jaddib/PACS-21-Hardware/README.md

# PACS-21-Hardware
Here is where we will store our schematics and PCBs
:)
