jaddib/PACS-21-Hardware/Added Component Footprints/ASPI_0630LR_3R3M_T15/ASPI-0630LR-3R3M-T15.step

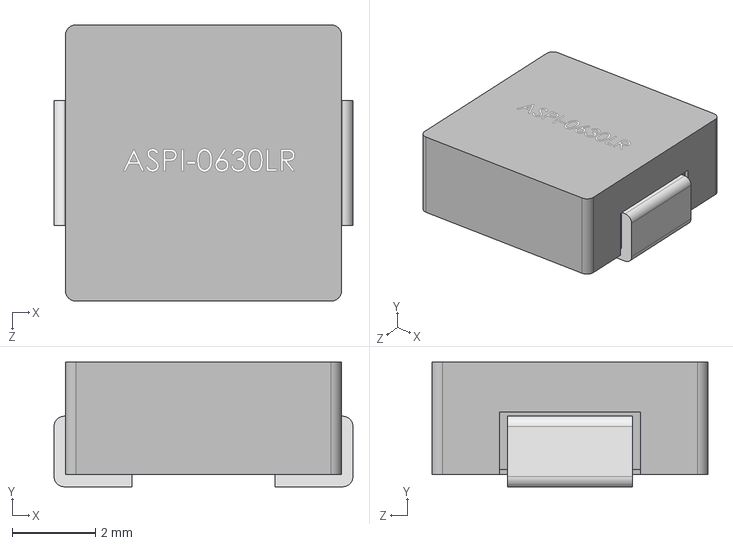
[picture p1: CAD file, 2025-01-23]
Added Component Footprints/ASPI_0630LR_3R3M_T15/ASPI-0630LR-3R3M-T15.step
7.20 x 3.00 x 6.65 mm
