jaddib/PACS-21-Hardware/Added Component Footprints/BSS84PH6327XTSA2/BSS84PH6327XTSA2.step

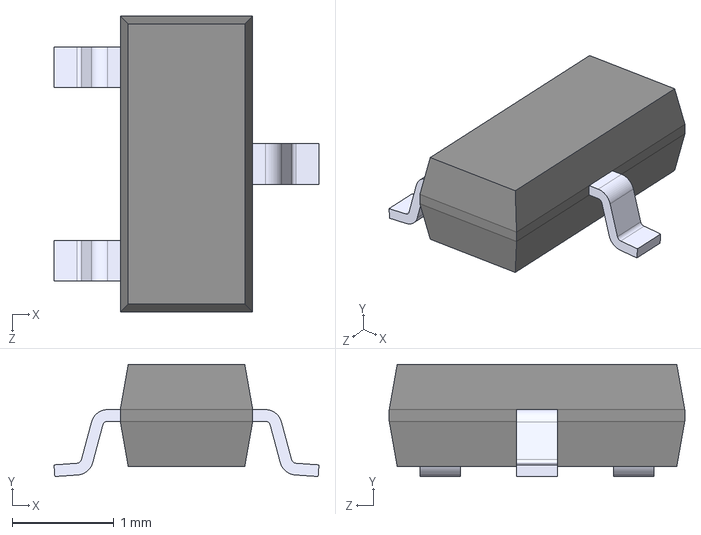
[picture p2: CAD file, 2024-12-08]
Added Component Footprints/BSS84PH6327XTSA2/BSS84PH6327XTSA2.step
2.60 x 1.10 x 2.90 mm
