jaddib/PACS-21-Hardware/Added Component Footprints/TPS562201DDCR/TPS562201DDCR.step

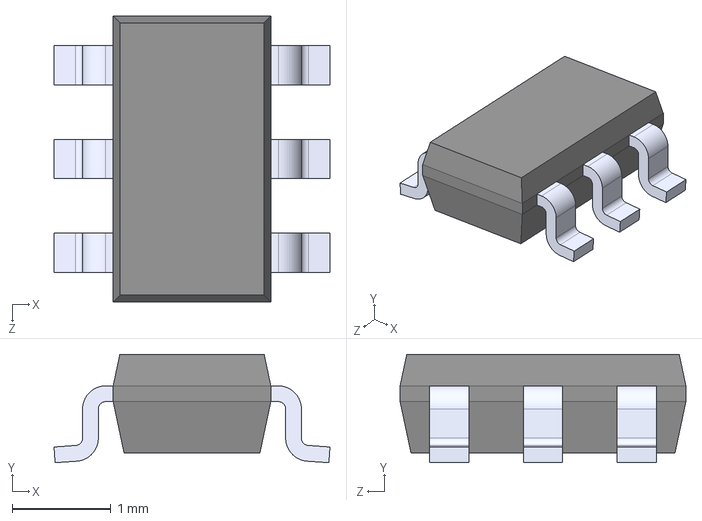
[picture p3: CAD file, 2024-11-30]
Added Component Footprints/TPS562201DDCR/TPS562201DDCR.step
2.80 x 1.10 x 2.90 mm
