jaddib/PACS-21-Hardware/(list of files, cad)

Other CAD files:
PACS Fusion Files/PACS Battery Box NEW v4.f3d
PACS Fusion Files/PACS PCB Box NEW v12.f3d
PACS Fusion Files/Plug for battery port v2.f3d
PACS Fusion Files/sprinkler for tube v1.f3d
