jaddib/PACS-21-Hardware/PACS_1.0/PACS_1.0.kicad_pcb

## KiCad design PACS_1.0/PACS_1.0.kicad_pcb (2025-02-16)

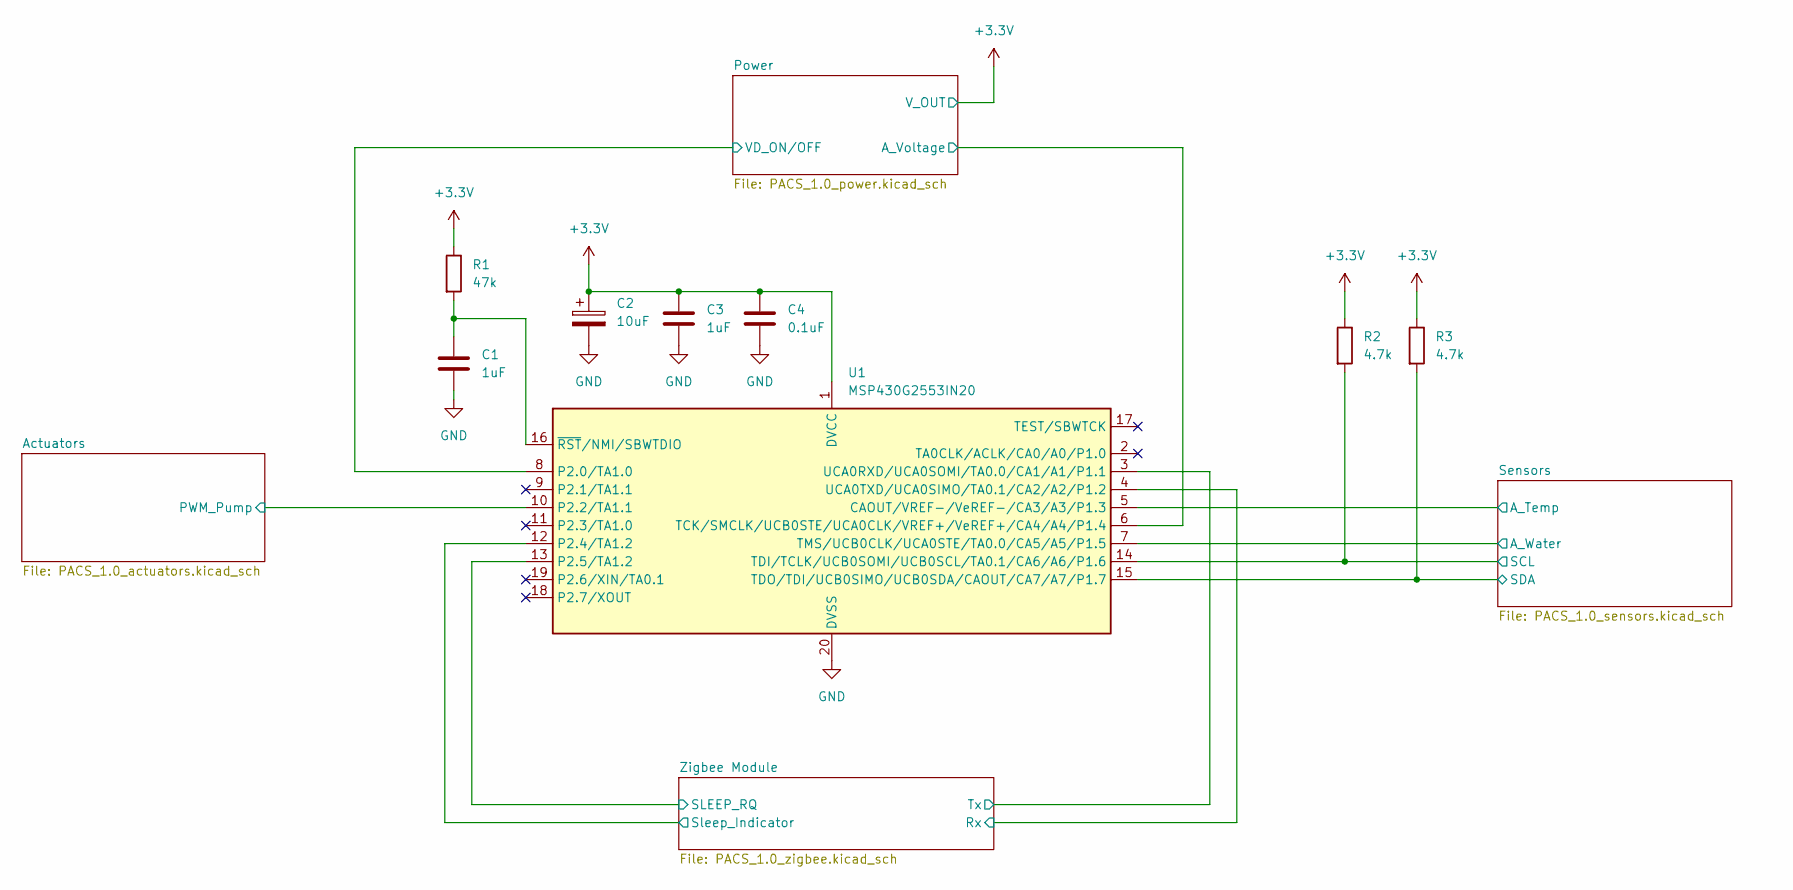
[picture p9: schematic PACS_1.0.kicad_sch, MCU and Connections]

Parts:
C1, C3: 1uF; C_0603_1608Metric
C2: 10uF; C_0805_2012Metric
C4: 0.1uF; C_0402_1005Metric
R1: 47k; R_0603_1608Metric
R2, R3: 4.7k; R_0402_1005Metric
U1: MSP430G2553IN20; DIP-20_W7.62mm

Connections:
+3.3V: C2.1, C3.1, C4.1, R1.1, R2.1, R3.1, U1.1 (DVCC); also elsewhere on the board
/Actuators/PWM_Pump: U1.10 (P2.2/TA1.1); also elsewhere on the board
/Power/A_Voltage: U1.6 (TCK/SMCLK/UCB0STE/UCA0CLK/VREF+/VeREF+/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); also elsewhere on the board
/Power/VD_ON/OFF: U1.8 (P2.0/TA1.0); also elsewhere on the board
/Sensors/A_Temp: U1.5 (CAOUT/VREF-/VeREF-/CA3/A3/P1.3); also elsewhere on the board
/Sensors/A_Water: U1.7 (TMS/UCB0CLK/UCA0STE/TA0.0/CA5/A5/P1.5); also elsewhere on the board
/Sensors/SCL: R2.2, U1.14 (TDI/TCLK/UCB0SOMI/UCB0SCL/TA0.1/CA6/A6/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); also elsewhere on the board
/Sensors/SDA: R3.2, U1.15 (TDO/TDI/UCB0SIMO/UCB0SDA/CAOUT/CA7/A7/P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); also elsewhere on the board
/Zigbee Module/Rx: U1.4 (UCA0TXD/UCA0SIMO/TA0.1/CA2/A2/P1.2); also elsewhere on the board
/Zigbee Module/SLEEP_RQ: U1.13 (P2.5/TA1.2); also elsewhere on the board
/Zigbee Module/Sleep_Indicator: U1.12 (P2.4/TA1.2); also elsewhere on the board
/Zigbee Module/Tx: U1.3 (UCA0RXD/UCA0SOMI/TA0.0/CA1/A1/P1.1); also elsewhere on the board
GND: C1.2, C2.2, C3.2, C4.2, U1.20 (DVSS); also elsewhere on the board
unnamed: C1.1, R1.2, U1.16 (~RST/NMI/SBWTDIO)

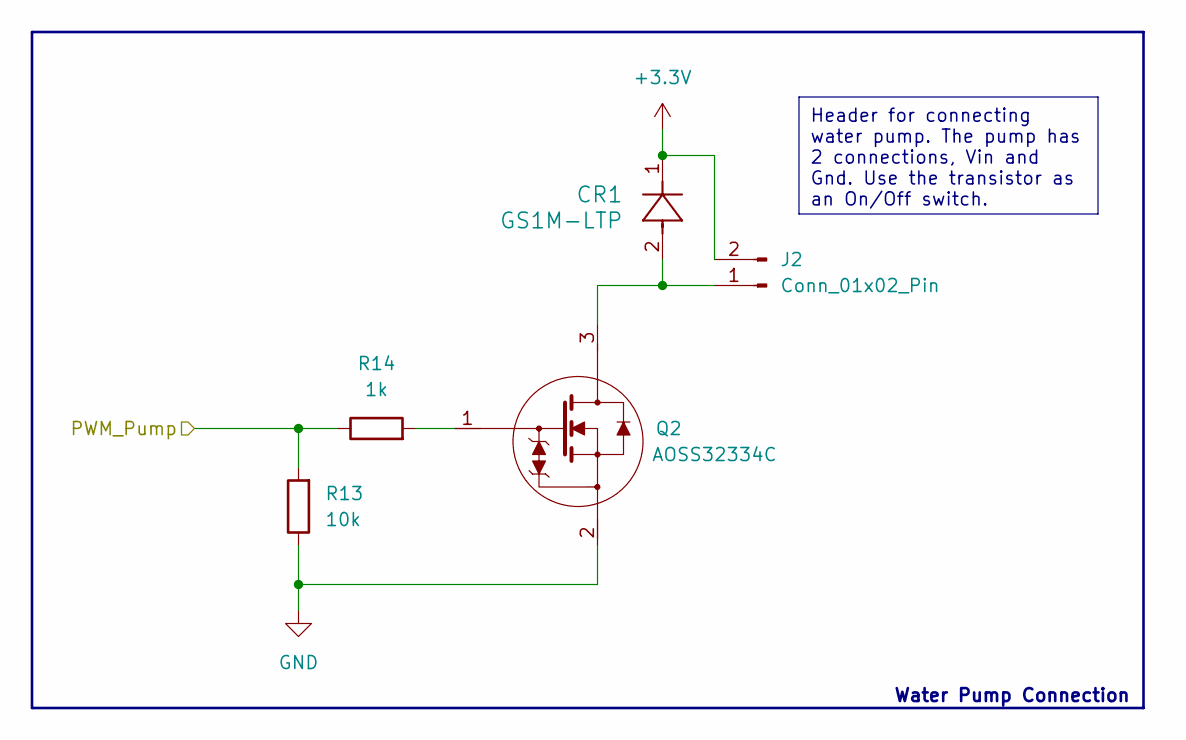
[picture p10: schematic PACS_1.0_actuators.kicad_sch, Water Pump]

Parts:
CR1: GS1M-LTP; D_SMA
J2: Conn_01x02_Pin; JST_EH_B2B-EH-A_1x02_P2.50mm_Vertical
Q2: TSOT-23
R13: 10k; R_0402_1005Metric
R14: 1k; R_0402_1005Metric

Connections:
+3.3V: CR1.1, J2.2; also elsewhere on the board
/Actuators/PWM_Pump: R13.2, R14.1; also elsewhere on the board
GND: Q2.2, R13.1; also elsewhere on the board
unnamed: CR1.2, J2.1, Q2.3
unnamed: Q2.1, R14.2

Notes on the sheet:
Header for connecting water pump. The pump has 2 connections, Vin and Gnd. Use the transistor as an On/Off switch.
Water Pump Connection

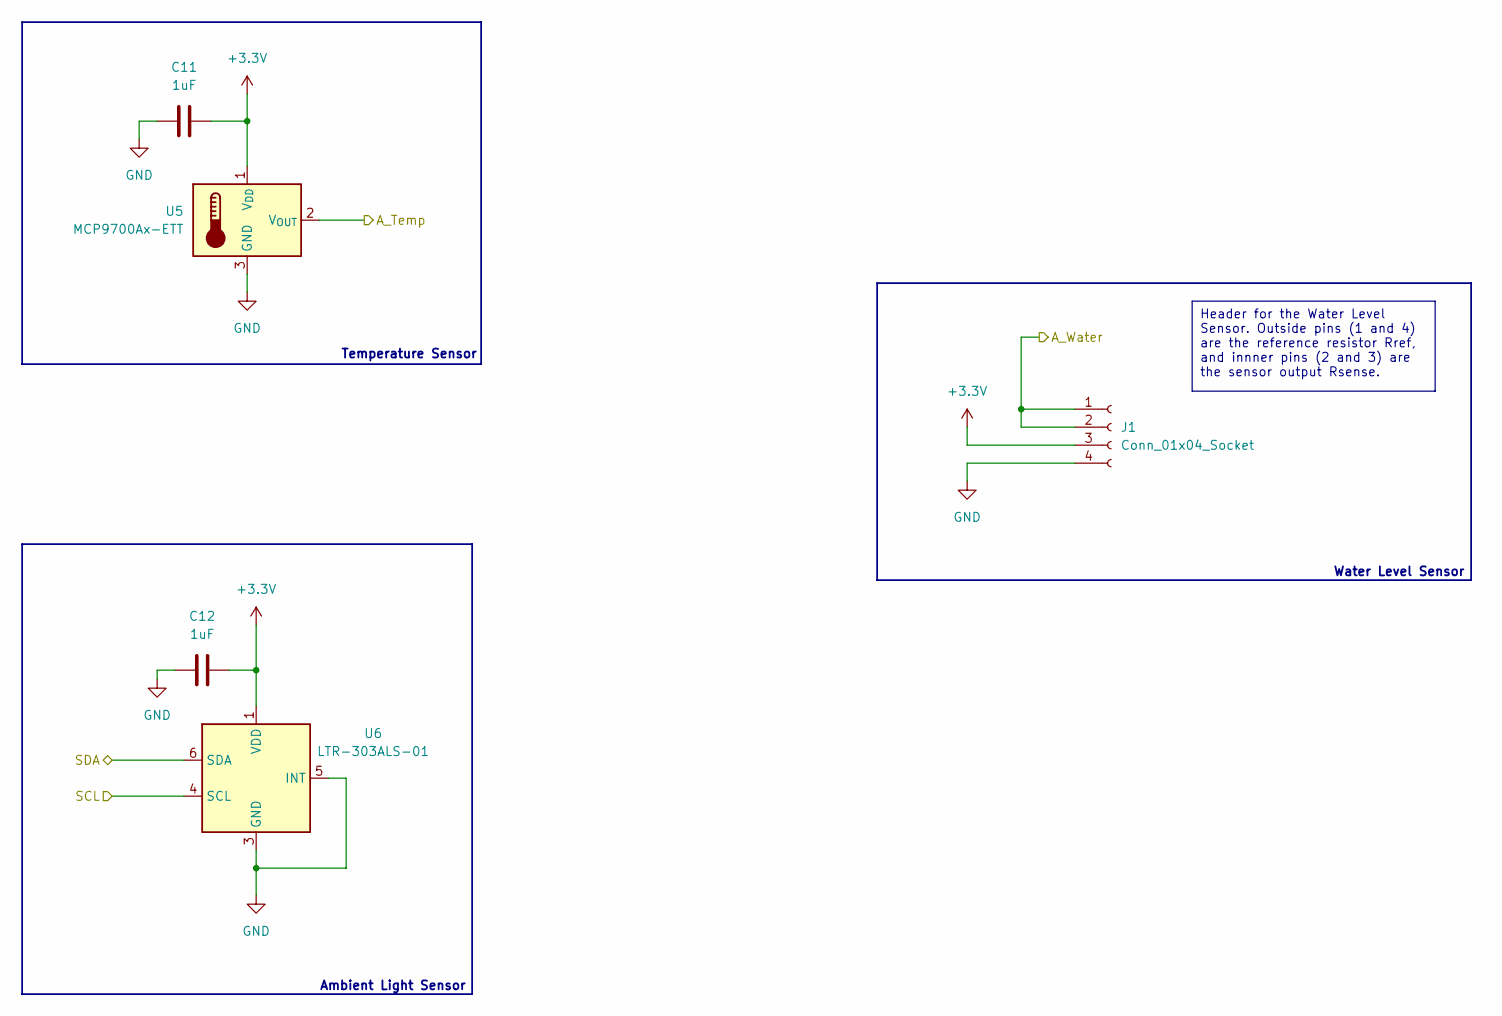
[picture p11: schematic PACS_1.0_sensors.kicad_sch, Sensors]

Parts:
C11, C12: 1uF; C_0603_1608Metric
J1: Conn_01x04_Socket; PinSocket_1x04_P2.54mm_Vertical
U5: MCP9700Ax-ETT; SOT-23
U6: LTR-303ALS-01; Lite-On_LTR-303ALS-01

Connections:
+3.3V: C11.2, C12.2, J1.3, U5.1 (V_{DD}), U6.1 (VDD); also elsewhere on the board
/Sensors/A_Temp: U5.2 (V_{OUT}); also elsewhere on the board
/Sensors/A_Water: J1.1, J1.2; also elsewhere on the board
/Sensors/SCL: U6.4 (SCL); also elsewhere on the board
/Sensors/SDA: U6.6 (SDA); also elsewhere on the board
GND: C11.1, C12.1, J1.4, U5.3 (GND), U6.3 (GND), U6.5 (INT); also elsewhere on the board

Notes on the sheet:
Header for the Water Level Sensor. Outside pins (1 and 4) are the reference resistor Rref, and innner pins (2 and 3) are the sensor output Rsense.
Water Level Sensor
Temperature Sensor
Ambient Light Sensor

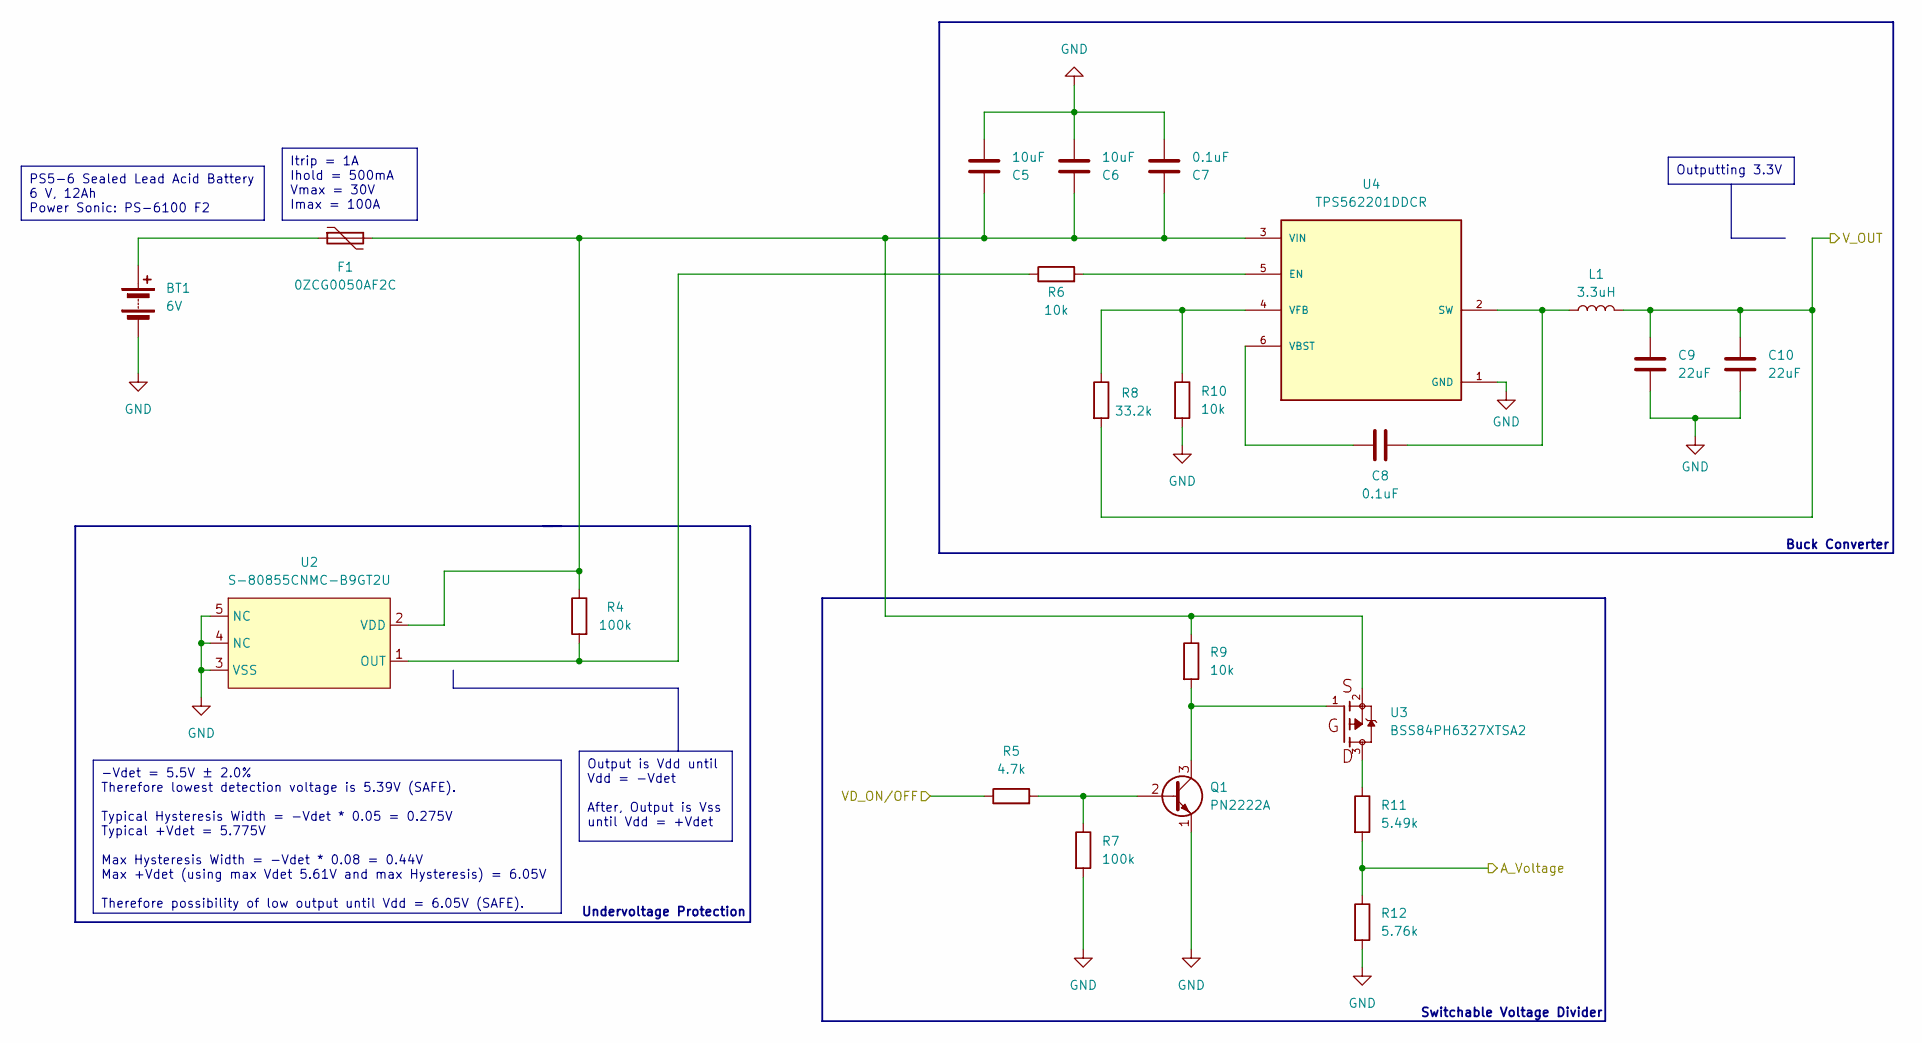
[picture p12: schematic PACS_1.0_power.kicad_sch, Power]

Parts:
BT1: 6V; JST_EH_B2B-EH-A_1x02_P2.50mm_Vertical
C5, C6: 10uF; C_0805_2012Metric
C7, C8: 0.1uF; C_0402_1005Metric
C9, C10: 22uF; C_0603_1608Metric
F1: 0ZCG0050AF2C; Fuse_1812_4532Metric
L1: 3.3uH; L_Abracon_ASPI-0630LR
Q1: PN2222A; TO-92_Inline
R4, R7: 100k; R_0402_1005Metric
R5: 4.7k; R_0402_1005Metric
R6, R9, R10: 10k; R_0402_1005Metric
R8: 33.2k; R_0402_1005Metric
R11: 5.49k; R_0603_1608Metric
R12: 5.76k; R_0603_1608Metric
U2: S-80855CNMC-B9GT2U; SOT-23-5
U3: BSS84PH6327XTSA2; TSOT-23
U4: TPS562201DDCR; SOT95P280X110-6N; PARTREV A

Connections:
+3.3V: C9.1, C10.1, L1.2, R8.2; also elsewhere on the board
/Power/A_Voltage: R11.2, R12.1; also elsewhere on the board
/Power/VD_ON/OFF: R5.1; also elsewhere on the board
GND: BT1.2 (-), C5.2, C6.2, C7.2, C9.2, C10.2, Q1.1 (E), R7.2, R10.2, R12.2, U2.3 (VSS), U2.4 (NC), U2.5 (NC), U4.1 (GND); also elsewhere on the board
unnamed: BT1.1 (+), F1.1
unnamed: Q1.2 (B), R5.2, R7.1
unnamed: Q1.3 (C), R9.2, U3.1
unnamed: R11.1, U3.3
unnamed: R4.2, R6.1, U2.1 (OUT)
unnamed: C5.1, C6.1, C7.1, F1.2, R4.1, R9.1, U2.2 (VDD), U3.2, U4.3 (VIN)
unnamed: R6.2, U4.5 (EN)
unnamed: C8.2, L1.1, U4.2 (SW)
unnamed: C8.1, U4.6 (VBST)
unnamed: R8.1, R10.1, U4.4 (VFB)

Notes on the sheet:
Output is Vdd until Vdd = -Vdet After, Output is Vss until Vdd = +Vdet
-Vdet = 5.5V ± 2.0% Therefore lowest detection voltage is 5.39V (SAFE). Typical Hysteresis Width = -Vdet * 0.05 = 0.275V Typical +Vdet = 5.775V Max Hysteresis Width = -Vdet * 0.08 = 0.44V Max +Vdet (using max Vdet 5.61V and max Hysteresis) = 6.05V Therefore possibility of low output until Vdd = 6.0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
Outputting 3.3V
Itrip = 1A Ihold = 500mA Vmax = 30V Imax = 100A
PS5-6 Sealed Lead Acid Battery 6 V, 12Ah Power Sonic: PS-6100 F2
Switchable Voltage Divider
Undervoltage Protection
Buck Converter

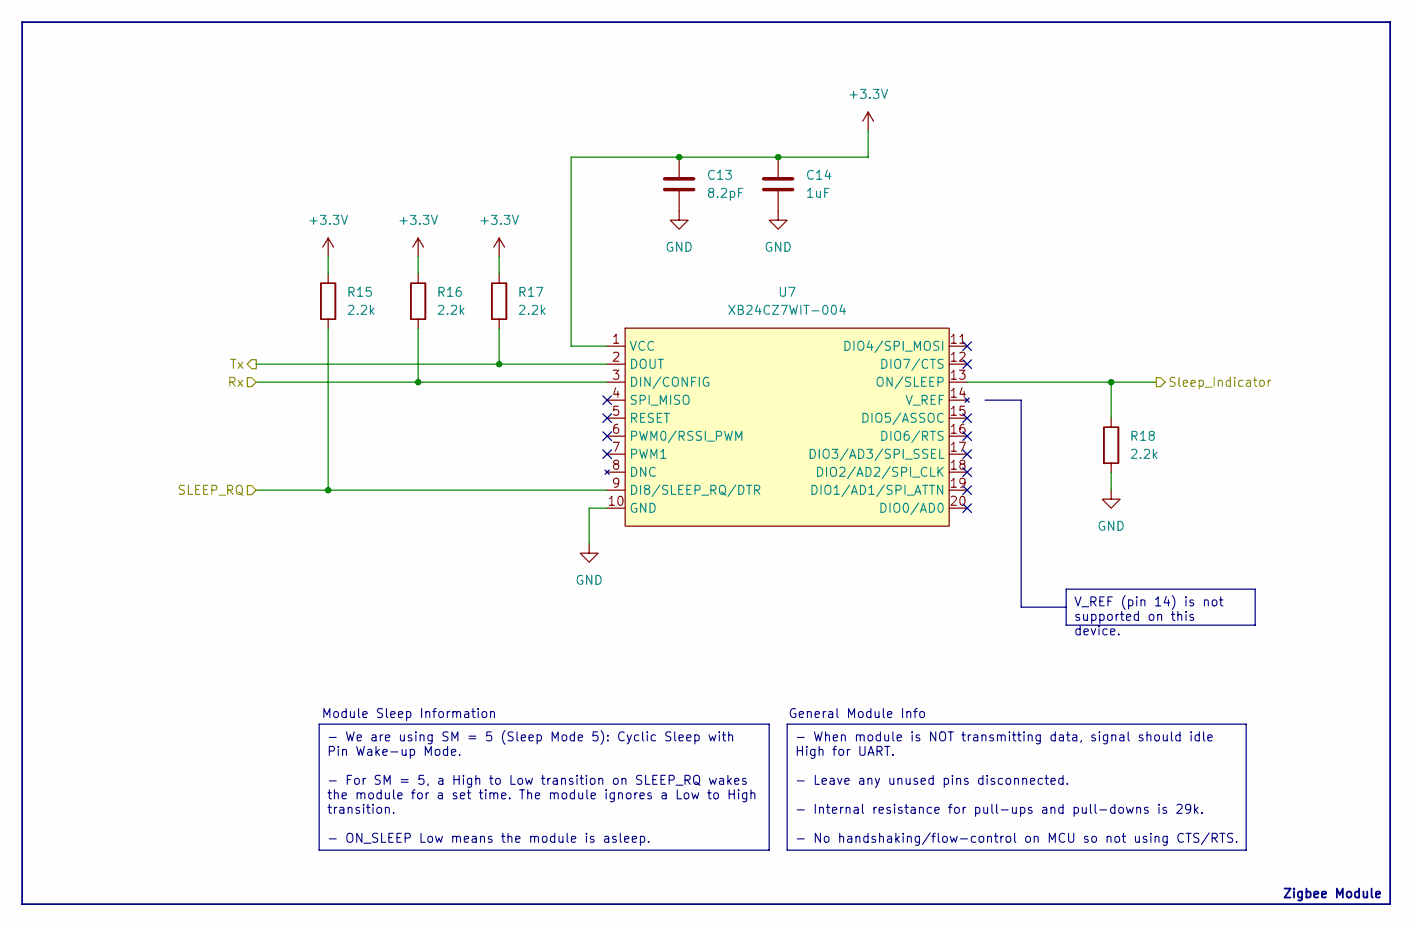
[picture p13: schematic PACS_1.0_zigbee.kicad_sch, Zigbee Module]

Parts:
C13: 8.2pF; C_0402_1005Metric
C14: 1uF; C_0603_1608Metric
R15, R16, R17, R18: 2.2k; R_0402_1005Metric
U7: XB24CZ7WIT-004

Connections:
+3.3V: C13.1, C14.1, R15.1, R16.1, R17.1, U7.1 (VCC); also elsewhere on the board
/Zigbee Module/Rx: R16.2, U7.3 (DIN/CONFIG); also elsewhere on the board
/Zigbee Module/SLEEP_RQ: R15.2, U7.9 (DI8/SLEEP_RQ/DTR); also elsewhere on the board
/Zigbee Module/Sleep_Indicator: R18.1, U7.13 (ON/SLEEP); also elsewhere on the board
/Zigbee Module/Tx: R17.2, U7.2 (DOUT); also elsewhere on the board
GND: C13.2, C14.2, R18.2, U7.10 (GND); also elsewhere on the board

Notes on the sheet:
V_REF (pin 14) is not supported on this device.
- We are using SM = 5 (Sleep Mode 5): Cyclic Sleep with Pin Wake-up Mode. - For SM = 5, a High to Low transition on SLEEP_RQ wakes the module for a set time. The module ignores a Low to High transition. - ON_SLEEP Low means the module is asleep.
- When module is NOT transmitting data, signal should idle High for UART. - Leave any unused pins disconnected. - Internal resistance for pull-ups and pull-downs is 29k. - No handshaking/flow-control on MCU so not using CTS/RTS.
Zigbee Module
Module Sleep Information
General Module Info

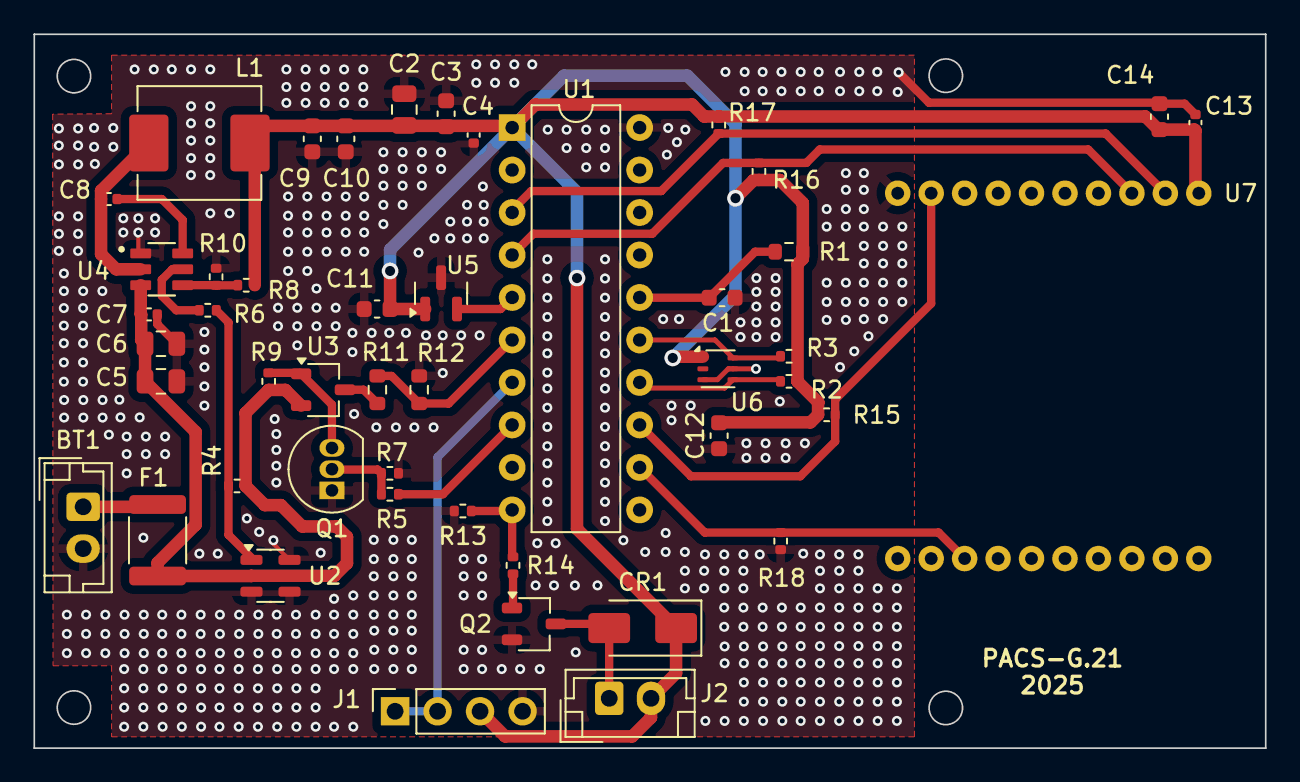
[picture p14: board PACS_1.0.kicad_pcb from above]

Board: 2 copper layers, 73.6 x 42.7 mm, 47 parts (0 on the bottom side), 26 nets.
