jaddib/PACS-21-Hardware/(commit log)

2024-11-28 Beginning of the Schematic
    barely anything in here
    [PACS_1.0.kicad_pcb, PACS_1.0.kicad_sch]
2024-11-28 Added New Sheets
    [PACS_1.0.kicad_sch, PACS_1.0_actuators.kicad_sch, PACS_1.0_power.kicad_sch, PACS_1.0_sensors.kicad_sch]
2024-11-30 Added Bucks, Temp and Light Sensor
    [PACS_1.0.kicad_pcb, PACS_1.0.kicad_sch, PACS_1.0_power.kicad_sch, PACS_1.0_sensors.kicad_sch, TPS562201DDCR.step]
2024-11-30 New Changes
    We had the discussion about water pump, INA, LEDS, and battery solution. Not much changes from previous night.
    [PACS_1.0.kicad_sch, PACS_1.0_leds.kicad_sch, PACS_1.0_power.kicad_sch, PACS_1.0_pump.kicad_sch, PACS_1.0_sensors.kicad_sch]
2024-12-01 Added Water level sensor and start of Pump
    [PACS_1.0.kicad_sch, PACS_1.0_power.kicad_sch, PACS_1.0_pump.kicad_sch, PACS_1.0_sensors.kicad_sch]
2024-12-01 Finished water pump, cleaned out empty sheets, added details in 'post its'
    [PACS_1.0.kicad_sch, PACS_1.0_actuators.kicad_sch, PACS_1.0_leds.kicad_sch, PACS_1.0_pump.kicad_sch, PACS_1.0_sensors.kicad_sch]
2024-12-01 Added LED schematic/PCB
    [PACS_LEDS_1.0.kicad_pcb, PACS_LEDS_1.0.kicad_sch]
2024-12-03 Finished Zigbee Module
    also fixed some library issues
    [PACS_1.0.kicad_sch, PACS_1.0_actuators.kicad_sch, PACS_1.0_power.kicad_sch, PACS_1.0_zigbee.kicad_sch]
2024-12-03 Added Undervoltage Protection, removed LED kicad
    [PACS_1.0_actuators.kicad_sch, PACS_1.0_power.kicad_sch, PACS_LEDS_1.0.kicad_pcb, PACS_LEDS_1.0.kicad_sch]
2024-12-04 Finished 1.0 (NO INA INCLUDED)
    Finished PACS 1.0 sheets, Power sheet needs considerations, no INA yet.
    [PACS_1.0.kicad_sch, PACS_1.0_actuators.kicad_sch, PACS_1.0_power.kicad_sch, PACS_1.0_sensors.kicad_sch, PACS_1.0_zigbee.kicad_sch]
2024-12-06 Changed Battery
    [PACS_1.0_power.kicad_sch]
2024-12-08 Added skeleton for Voltage Divide
    [BSS84PH6327XTSA2.step, PACS_1.0_power.kicad_sch]
2024-12-09 Finished Voltage Divider
    [PACS_1.0_power.kicad_sch]
2024-12-09 COMPLETE PACS v1.0
    [PACS_1.0.kicad_sch, PACS_1.0_power.kicad_sch]
2024-12-09 Changed reference for Components
    C8 to C2 (AS EXAMPLE)
    [PACS_1.0.kicad_sch, PACS_1.0_actuators.kicad_sch, PACS_1.0_power.kicad_sch, PACS_1.0_sensors.kicad_sch, PACS_1.0_zigbee.kicad_sch]
2024-12-09 Changed 5.5k resistor to 5.49k
    [PACS_1.0_power.kicad_sch]
2024-12-10 Uploaded the PDF of schematic
2024-12-10 Added Boxes and fixed PDF
    [PACS_1.0_power.kicad_sch, PACS_1.0_zigbee.kicad_sch]
2025-01-10 Updated footprints for caps and resistors
    [PACS_1.0.kicad_sch, PACS_1.0_actuators.kicad_sch, PACS_1.0_power.kicad_sch, PACS_1.0_sensors.kicad_sch, PACS_1.0_zigbee.kicad_sch]
2025-01-17 added more footprints
    [PACS_1.0_actuators.kicad_sch, PACS_1.0_power.kicad_sch]
2025-01-23 Started the PCB design
    added several footprints, need to find footprint for Xbee, need to add traces for GND and power
    [ASPI-0630LR-3R3M-T15.step, PACS_1.0.kicad_pcb, PACS_1.0_actuators.kicad_sch, PACS_1.0_power.kicad_sch, PACS_1.0_sensors.kicad_sch, PACS_1.0_zigbee.kicad_sch]
2025-01-28 FINISHED PCB DESIGN
    must double check that the dimensions for XBee footprint are correct
    [PACS_1.0.kicad_pcb, PACS_1.0_power.kicad_sch, PACS_1.0_zigbee.kicad_sch]
2025-01-28 added stitching vias, still need more
    fix library issues
    [PACS_1.0.kicad_pcb]
2025-01-30 Added stitching vias
    added names to backside of pcb
    [PACS_1.0.kicad_pcb]
2025-02-05 finalized v1.0
    [PACS_1.0.kicad_pcb]
2025-02-05 gerber files
    [PACS_1.0-B_Cu.gbr, PACS_1.0-B_Mask.gbr, PACS_1.0-B_Paste.gbr, PACS_1.0-B_Silkscreen.gbr, PACS_1.0-Edge_Cuts.gbr, PACS_1.0-F_Cu.gbr, PACS_1.0-F_Mask.gbr, PACS_1.0-F_Paste.gbr]
2025-02-13 revised PCB with Zoltan housekeeping
    still needs tons of vias for stitching ground planes
    [PACS_1.0.kicad_pcb]
2025-02-13 Finished stitching vias
    i think officially complete
    [PACS_1.0.kicad_pcb]
2025-02-14 Uploaded PCB to Casptone r1.0
    had to change via sizes to avoid extra costs, set a standard for ground and 3V3
    [PACS_1.0-B_Cu.gbl, PACS_1.0-B_Cu.gbr, PACS_1.0-B_Mask.gbs, PACS_1.0-B_Paste.gbp, PACS_1.0-B_Paste.gbr, PACS_1.0-B_Silkscreen.gbo, PACS_1.0-Edge_Cuts.gm1, PACS_1.0-F_Cu.gbr]
2025-02-16 Removed silkscreen from stitching vias
    created new set of gerber files, revision 2.0
    [PACS_1.0-B_Cu.gbl, PACS_1.0-B_Mask.gbs, PACS_1.0-B_Paste.gbp, PACS_1.0-B_Silkscreen.gbo, PACS_1.0-Edge_Cuts.gm1, PACS_1.0-F_Cu.gtl, PACS_1.0-F_Mask.gts, PACS_1.0-F_Paste.gtp]
2025-04-10 Add files via upload
    This repository contains Fusion 360 design files for the Plant Automated Care System (PACS). It includes 3D models for the custom enclosure components: the battery compartment, PCB housing, lid for the PCB, and a sprinkler head designed to connect to an 8mm PVC tube. These parts are optimized for 3D printing in PETG and designed for modular assembly and water resistance.
    [PACS Battery Box NEW v4.f3d, PACS PCB Box NEW v12.f3d, Plug for battery port v2.f3d, sprinkler for tube v1.f3d]
